antmicro/stm32h7-renode-reference-platform/(notices)

Notices in the files:
parts and their libraries:
License: Apache-2.0
